bobdrzyzgula/Header-Soldering-Jigs/README.md

# Header Soldering Jigs

*Written by Claude at Bob's direction.*

These are 3D-printable stands for soldering 0.1" pin headers onto microcontroller boards so the headers come out straight. Each board has its own folder with an OpenSCAD model, ready-to-print STLs and a README.

## How the stands work

- **The jig:** a block with a hole for every pin. The holes are drawn at 1.3 mm, go through the full 8 mm thickness of the block, and are chamfered at both ends.
- **Using it:**
  1. Put generic male headers in the holes, **long pins down**, so their plastic bodies sit flat on the top face.
  2. Lay the board on the short pins.
  3. Tack the corners, check that the board is flat, then solder the rest.
- **Why it works:** the depth of the holes keeps the pins parallel. The board rests only on the header bodies, which keeps it square to the pins.

Each board has two versions:

- **`body_bottom`:** the header plastic goes under the board, the normal mounting. The board goes in components up, and the top of the stand is flat.
- **`body_top`:** the header plastic goes on the component side. The board goes in components down, and the top of the stand is pocketed to clear the parts.

## Boards

| Folder | Board | Pins | Geometry source |
|---|---|---|---|
| [`rp2350b-controller/`](rp2350b-controller/) | WeAct Studio RP2350B Core Board, used in the sewing-machine motor controller | 2×15 + 2×15 + 1×4 | `HDK/3D_RP350B.step` from [WeAct's repository](https://github.com/WeActStudio/WeActStudio.RP2350BCoreBoard) |
| [`pico2/`](pico2/) | Raspberry Pi Pico 2 (RP2350A) | 2×20 + 3-pin debug | Raspberry Pi Pico 2 datasheet, Figure 3 |

## KiCad library

[`kicad/`](kicad/) contains footprints and schematic symbols for both boards (the `MCU_Module_Boards` library), for designing carrier boards that host them. Its README has the full pin tables.

## Printing

- Print with the top face up. No supports are needed.
- Holes are drawn at 1.3 mm. FDM printing makes holes smaller than drawn, and the Pico 2 stand printed at 1.0 mm needed its holes opened to 1.3 mm, after which it worked well. If your printer's holes come out tight or loose, adjust `hole_d` in the Customizer (0.05 mm steps).
- Every numeric parameter has a range and step set, so the OpenSCAD Customizer keeps decimal values instead of rounding them to whole numbers.
