bobdrzyzgula/Header-Soldering-Jigs/pico2/pico2_stand_top_views.png

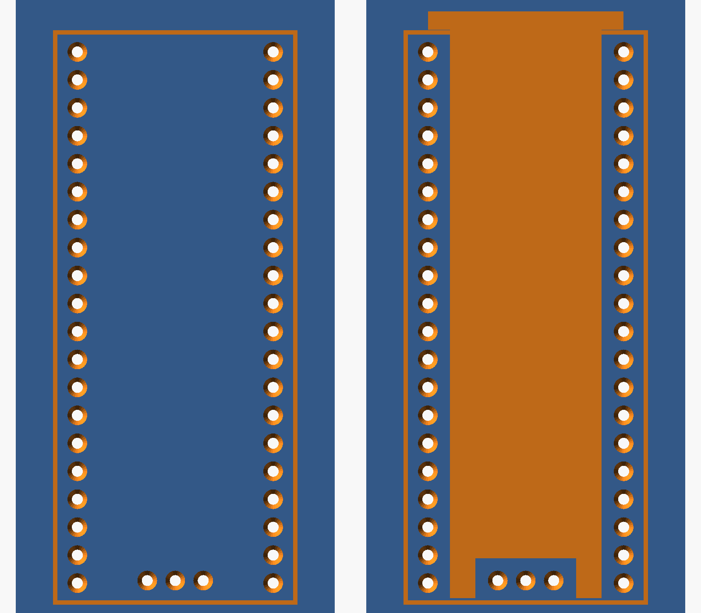
pico2/pico2_stand_top_views.png
