bobdrzyzgula/Header-Soldering-Jigs/rp2350b-controller/rp2350b_stand_body_top_preview.png

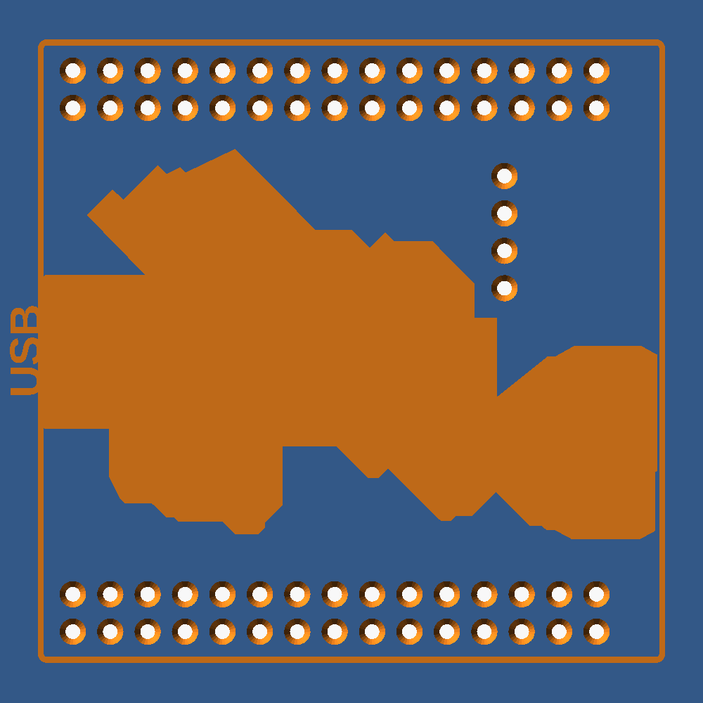
rp2350b-controller/rp2350b_stand_body_top_preview.png
