bobdrzyzgula/Header-Soldering-Jigs/pico2/pico2_stand_body_top.stl

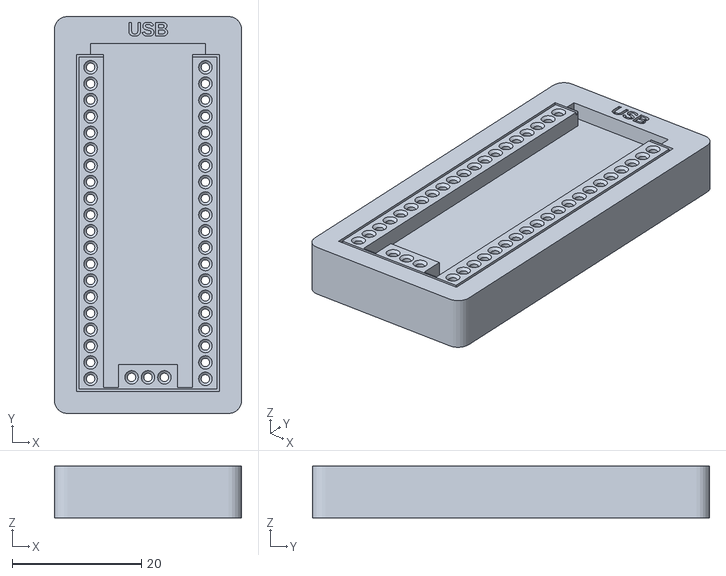
[picture p5: CAD file, 2026-10-26]
pico2/pico2_stand_body_top.stl
29.0 x 61.5 x 8.00
