bobdrzyzgula/Header-Soldering-Jigs/rp2350b-controller/rp2350b_stand_body_bottom.stl

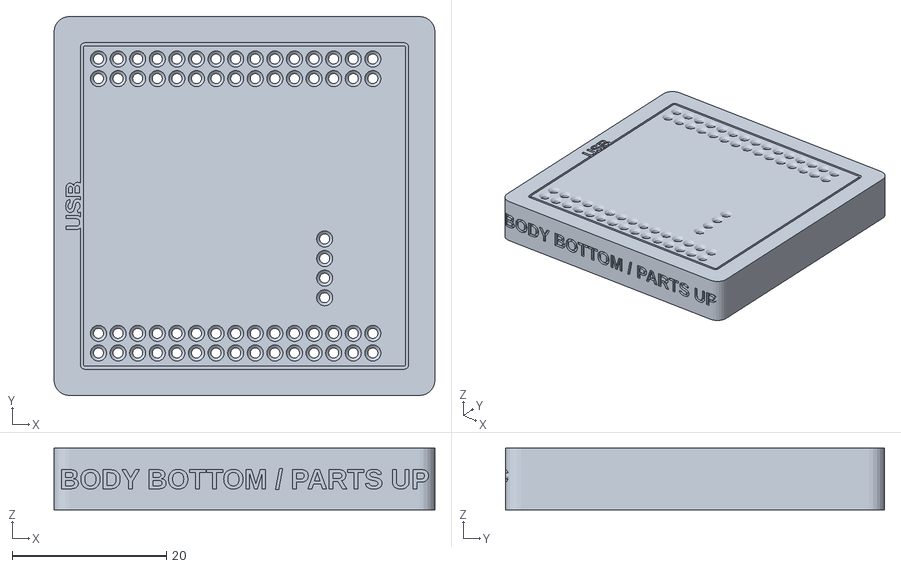
[picture p6: CAD file, 2026-11-07]
rp2350b-controller/rp2350b_stand_body_bottom.stl
49.4 x 49.1 x 8.00
