bobdrzyzgula/Header-Soldering-Jigs/pico2/pico2_stand_body_bottom.stl

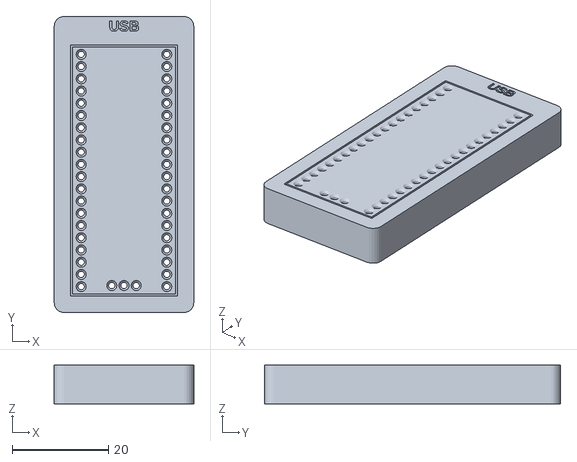
[picture p7: CAD file, 2026-10-26]
pico2/pico2_stand_body_bottom.stl
29.0 x 61.5 x 8.00
