bobdrzyzgula/Header-Soldering-Jigs/rp2350b-controller/rp2350b_data.scad

// ---- Data extracted from 3D_RP350B.step (WeActStudio.RP2350BCoreBoard repo, HDK/, commit 5b165b5; board coordinates, mm; board top face at z=1.6) ----
// Generated by extract_step_to_scad.py
BOARD_MIN = [0.013, -41.135];
BOARD_MAX = [41.389, -0.013];
BOARD_YC  = -20.574;          // centre line the hole pattern is symmetric about (flip axis)
OUTER_PINS = [[1.778,-1.524], [4.318,-1.524], [6.858,-1.524], [9.398,-1.524], [11.938,-1.524], [14.478,-1.524], [17.018,-1.524], [19.558,-1.524], [22.098,-1.524], [24.638,-1.524], [27.178,-1.524], [29.718,-1.524], [32.258,-1.524], [34.798,-1.524], [37.338,-1.524], [1.778,-4.064], [4.318,-4.064], [6.858,-4.064], [9.398,-4.064], [11.938,-4.064], [14.478,-4.064], [17.018,-4.064], [19.558,-4.064], [22.098,-4.064], [24.638,-4.064], [27.178,-4.064], [29.718,-4.064], [32.258,-4.064], [34.798,-4.064], [37.338,-4.064], [1.778,-37.084], [4.318,-37.084], [6.858,-37.084], [9.398,-37.084], [11.938,-37.084], [14.478,-37.084], [17.018,-37.084], [19.558,-37.084], [22.098,-37.084], [24.638,-37.084], [27.178,-37.084], [29.718,-37.084], [32.258,-37.084], [34.798,-37.084], [37.338,-37.084], [1.778,-39.624], [4.318,-39.624], [6.858,-39.624], [9.398,-39.624], [11.938,-39.624], [14.478,-39.624], [17.018,-39.624], [19.558,-39.624], [22.098,-39.624], [24.638,-39.624], [27.178,-39.624], [29.718,-39.624], [32.258,-39.624], [34.798,-39.624], [37.338,-39.624]];
MID_PINS = [[31.090,-24.845], [31.090,-27.385], [31.090,-29.925], [31.090,-32.465]];
MOUNT_HOLES = [[1.143,-40.005], [1.143,-1.143], [40.259,-40.005], [40.259,-1.143]];
// Top-side components: [name, height above board top, 2D convex outline]
COMPONENTS = [
  ["SxsA-C2-0402_SMT_L", 0.50, [[33.010,-19.160], [33.020,-19.170], [33.490,-19.170], [33.510,-19.150], [33.510,-18.190], [33.500,-18.170], [33.010,-18.170]]],
  ["SxsA-C2-0402_SMT_L", 0.50, [[33.170,-14.700], [33.660,-14.700], [33.670,-14.680], [33.670,-13.720], [33.650,-13.700], [33.180,-13.700], [33.170,-13.710]]],
  ["SxsA-C2-0402_SMT_L", 0.50, [[13.090,-9.390], [14.090,-9.390], [14.090,-8.910], [14.070,-8.890], [13.100,-8.890], [13.090,-8.900]]],
  ["SxsA-C2-0402_SMT_L", 0.50, [[26.780,-24.980], [27.470,-25.670], [27.490,-25.670], [27.820,-25.340], [27.830,-25.330], [27.830,-25.320], [27.590,-25.070], [27.510,-24.990], [27.290,-24.770], [27.130,-24.620], [27.110,-24.630], [26.780,-24.960]]],
  ["SxsA-C2-0402_SMT_L", 0.50, [[25.770,-14.950], [26.040,-15.220], [26.450,-15.630], [26.480,-15.630], [26.810,-15.300], [26.810,-15.280], [26.120,-14.590], [26.100,-14.590], [25.770,-14.920]]],
  ["SxsA-C2-0402_SMT_L", 0.50, [[17.260,-15.710], [17.560,-16.010], [17.580,-16.030], [17.950,-16.400], [17.960,-16.400], [18.300,-16.070], [18.300,-16.040], [17.620,-15.360], [17.610,-15.350], [17.600,-15.350], [17.260,-15.680]]],
  ["SxsA-C2-0402_SMT_L", 0.50, [[21.450,-13.400], [21.780,-13.730], [21.810,-13.730], [22.490,-13.050], [22.490,-13.020], [22.160,-12.690], [22.130,-12.690], [21.450,-13.370]]],
  ["SxsA-C2-0402_SMT_L", 0.50, [[28.840,-23.610], [28.850,-23.620], [29.830,-23.620], [29.840,-23.610], [29.840,-23.130], [29.830,-23.120], [28.840,-23.120]]],
  ["SxsA-C2-0402_SMT_L", 0.50, [[17.130,-24.830], [17.470,-25.160], [17.490,-25.160], [17.730,-24.920], [18.170,-24.480], [18.170,-24.450], [17.840,-24.120], [17.820,-24.120], [17.130,-24.800]]],
  ["SxsA-C2-0402_SMT_L", 0.50, [[13.090,-21.210], [13.100,-21.220], [13.570,-21.220], [13.580,-21.210], [13.590,-21.200], [13.590,-20.240], [13.580,-20.220], [13.090,-20.220]]],
  ["SxsA-C2-0402_SMT_L", 0.50, [[14.340,-18.480], [14.670,-18.810], [14.690,-18.810], [15.380,-18.130], [15.380,-18.100], [15.050,-17.770], [15.020,-17.770], [14.340,-18.450]]],
  ["SxsA-C2-0402_SMT_L", 0.50, [[29.070,-17.970], [29.400,-18.300], [29.430,-18.300], [30.110,-17.620], [30.110,-17.590], [29.780,-17.260], [29.750,-17.260], [29.520,-17.490], [29.380,-17.630], [29.070,-17.940]]],
  ["SxsA-C2-0402_SMT_L", 0.50, [[28.180,-15.680], [28.520,-16.020], [28.530,-16.020], [29.070,-15.480], [29.220,-15.330], [29.220,-15.300], [28.890,-14.970], [28.870,-14.970], [28.860,-14.980], [28.720,-15.120], [28.330,-15.510], [28.180,-15.660]]],
  ["SxsA-C2-0402_SMT_L", 0.50, [[25.400,-27.280], [25.420,-27.300], [25.890,-27.300], [25.900,-27.290], [25.900,-26.300], [25.410,-26.300], [25.400,-26.310]]],
  ["SxsA-C2-0402_SMT_L", 0.50, [[19.940,-28.050], [19.950,-28.060], [20.430,-28.060], [20.440,-28.050], [20.440,-27.060], [19.950,-27.060], [19.940,-27.070]]],
  ["SxsA-C2-0402_SMT_L", 0.50, [[14.230,-21.330], [14.250,-21.340], [15.220,-21.340], [15.230,-21.330], [15.230,-20.840], [14.240,-20.840], [14.230,-20.850]]],
  ["SxsA-C2-0402_SMT_L", 0.50, [[5.850,-28.350], [6.170,-28.670], [6.390,-28.890], [6.540,-29.040], [6.560,-29.040], [6.570,-29.030], [6.890,-28.710], [6.900,-28.700], [6.900,-28.690], [6.360,-28.140], [6.210,-28.000], [6.180,-28.000], [5.850,-28.330]]],
  ["SxsA-C2-0402_SMT_L", 0.50, [[17.890,-15.200], [18.150,-15.460], [18.580,-15.890], [18.600,-15.890], [18.940,-15.550], [18.940,-15.540], [18.400,-14.990], [18.250,-14.850], [18.220,-14.850], [17.890,-15.180]]],
  ["SxsA-C2-0402_SMT_L", 0.50, [[13.450,-24.600], [13.790,-24.940], [14.130,-25.280], [14.140,-25.290], [14.150,-25.290], [14.490,-24.960], [14.490,-24.930], [13.800,-24.240], [13.790,-24.240], [13.450,-24.570]]],
  ["SxsA-C2-0402_SMT_L", 0.50, [[27.420,-14.060], [27.580,-14.220], [28.110,-14.750], [28.120,-14.750], [28.460,-14.410], [28.460,-14.390], [28.190,-14.120], [27.920,-13.850], [27.770,-13.700], [27.750,-13.700], [27.420,-14.030]]],
  ["SxsA-C2-0402_SMT_L", 0.50, [[26.400,-10.470], [26.740,-10.810], [26.760,-10.810], [27.300,-10.270], [27.450,-10.110], [27.440,-10.100], [27.110,-9.770], [27.090,-9.770], [26.940,-9.910], [26.830,-10.020], [26.400,-10.450]]],
  ["SxsA-C2-0402_SMT_L", 0.50, [[33.070,-10.470], [33.080,-10.480], [33.570,-10.480], [33.570,-9.490], [33.550,-9.480], [33.090,-9.480], [33.080,-9.490], [33.070,-9.500]]],
  ["SxsA-C2-0402_SMT_L", 0.50, [[8.380,-11.050], [8.870,-11.050], [8.880,-11.040], [8.880,-10.070], [8.860,-10.050], [8.390,-10.050], [8.380,-10.060]]],
  ["COMPOUND", 1.20, [[10.770,-12.300], [11.470,-12.590], [12.950,-12.590], [13.660,-12.300], [13.660,-10.100], [13.650,-10.090], [12.950,-9.810], [11.470,-9.810], [10.770,-10.090]]],
  ["SxsA-C1-C0603", 0.80, [[14.460,-11.980], [14.470,-11.990], [15.250,-11.990], [15.260,-11.980], [15.260,-10.400], [15.250,-10.390], [14.460,-10.390]]],
  ["SxsA-C1-C0603", 0.80, [[9.230,-11.360], [10.020,-11.360], [10.030,-11.350], [10.030,-9.780], [10.010,-9.760], [9.240,-9.760], [9.230,-9.770]]],
  ["COMPOUND", 0.36, [[10.800,-13.710], [11.800,-13.710], [11.800,-13.210], [10.800,-13.210]]],
  ["COMPOUND", 0.36, [[8.890,-22.600], [9.890,-22.600], [9.890,-22.100], [8.890,-22.100]]],
  ["COMPOUND", 0.36, [[10.680,-18.920], [11.680,-18.920], [11.680,-18.420], [10.680,-18.420]]],
  ["COMPOUND", 0.36, [[14.960,-19.100], [15.320,-19.450], [15.540,-19.240], [15.550,-19.230], [15.840,-18.940], [16.020,-18.750], [15.670,-18.390], [14.980,-19.080]]],
  ["COMPOUND", 0.36, [[14.230,-20.440], [15.230,-20.440], [15.230,-19.940], [14.230,-19.940]]],
  ["COMPOUND", 0.36, [[15.470,-26.470], [15.830,-26.820], [15.970,-26.680], [16.360,-26.290], [16.530,-26.110], [16.180,-25.760], [15.950,-25.980], [15.940,-25.990], [15.690,-26.240], [15.610,-26.320]]],
  ["COMPOUND", 0.36, [[14.840,-25.830], [15.190,-26.180], [15.210,-26.170], [15.900,-25.480], [15.540,-25.120], [15.280,-25.380], [14.850,-25.810]]],
  ["COMPOUND", 0.36, [[6.840,-31.450], [6.850,-31.460], [7.010,-31.620], [7.530,-32.140], [7.540,-32.150], [7.900,-31.800], [7.680,-31.580], [7.410,-31.310], [7.190,-31.090]]],
  ["COMPOUND", 0.36, [[8.230,-31.450], [8.370,-31.590], [8.920,-32.140], [8.940,-32.150], [9.290,-31.800], [9.280,-31.780], [9.080,-31.580], [8.810,-31.310], [8.590,-31.090]]],
  ["COMPOUND", 0.36, [[6.840,-30.050], [6.850,-30.070], [7.060,-30.280], [7.540,-30.760], [7.900,-30.400], [7.210,-29.710], [7.190,-29.700]]],
  ["COMPOUND", 0.36, [[5.180,-29.030], [5.510,-29.370], [5.670,-29.530], [5.890,-29.740], [6.250,-29.390], [5.720,-28.860], [5.540,-28.680]]],
  ["COMPOUND", 0.36, [[3.790,-29.800], [4.000,-30.010], [4.270,-30.280], [4.490,-30.500], [4.850,-30.150], [4.280,-29.580], [4.160,-29.460], [4.140,-29.440]]],
  ["COMPOUND", 0.36, [[26.140,-12.780], [26.490,-13.130], [26.830,-13.470], [26.850,-13.480], [27.200,-13.130], [27.180,-13.110], [26.670,-12.600], [26.510,-12.440], [26.490,-12.420]]],
  ["COMPOUND", 0.36, [[33.280,-12.700], [34.280,-12.700], [34.280,-12.200], [33.280,-12.200]]],
  ["COMPOUND", 0.36, [[32.650,-15.850], [33.650,-15.850], [33.650,-15.350], [32.650,-15.350]]],
  ["COMPOUND", 0.36, [[33.280,-11.920], [34.280,-11.920], [34.280,-11.420], [33.280,-11.420]]],
  ["COMPOUND", 0.36, [[31.120,-16.770], [31.620,-16.770], [31.620,-15.770], [31.120,-15.770]]],
  ["COMPOUND", 0.36, [[12.580,-14.980], [13.580,-14.980], [13.580,-14.480], [12.580,-14.480]]],
  ["COMPOUND", 0.60, [[12.170,-17.050], [12.970,-17.050], [12.970,-15.450], [12.170,-15.450]]],
  ["COMPOUND", 0.71, [[34.100,-14.740], [34.350,-14.940], [34.650,-14.940], [34.890,-14.740], [34.900,-14.730], [34.900,-13.550], [34.890,-13.540], [34.640,-13.340], [34.350,-13.340], [34.110,-13.540], [34.100,-13.550]]],
  ["COMPOUND", 0.71, [[8.990,-18.000], [9.000,-18.010], [9.240,-18.210], [9.540,-18.210], [9.780,-18.010], [9.790,-18.000], [9.790,-16.820], [9.780,-16.810], [9.540,-16.610], [9.240,-16.610], [9.000,-16.810], [8.990,-16.820]]],
  ["COMPOUND", 0.71, [[8.850,-21.610], [9.050,-21.850], [9.060,-21.860], [10.250,-21.860], [10.450,-21.610], [10.450,-21.310], [10.250,-21.070], [10.240,-21.060], [9.060,-21.060], [9.050,-21.070], [8.850,-21.320]]],
  ["COMPOUND", 0.71, [[8.730,-19.710], [8.930,-19.950], [8.940,-19.960], [10.110,-19.960], [10.130,-19.940], [10.330,-19.700], [10.330,-19.420], [10.120,-19.160], [8.930,-19.160], [8.730,-19.410]]],
  ["COMPOUND", 0.71, [[33.940,-10.580], [34.190,-10.780], [34.490,-10.780], [34.730,-10.580], [34.740,-10.570], [34.740,-9.400], [34.720,-9.380], [34.480,-9.180], [34.200,-9.180], [33.940,-9.390]]],
  ["COMPOUND", 0.71, [[34.030,-19.260], [34.040,-19.270], [34.290,-19.470], [34.580,-19.470], [34.820,-19.270], [34.830,-19.260], [34.830,-18.070], [34.580,-17.870], [34.280,-17.870], [34.040,-18.070], [34.030,-18.080]]],
  ["SxsA-L1-RP2350_80QFN_minimal:L_pol_2016", 1.01, [[13.750,-23.640], [13.760,-23.670], [14.620,-24.530], [15.050,-24.960], [15.090,-24.980], [15.120,-24.990], [15.140,-24.990], [15.190,-24.970], [15.210,-24.960], [16.200,-23.970], [16.210,-23.950], [16.220,-23.930], [16.230,-23.900], [16.230,-23.880], [16.220,-23.850], [16.210,-23.830], [16.200,-23.810], [14.900,-22.520], [14.880,-22.510], [14.810,-22.510], [14.790,-22.520], [14.770,-22.540], [13.760,-23.550], [13.750,-23.570]]],
  ["COMPOUND", 0.60, [[32.100,-17.290], [33.700,-17.290], [33.700,-16.490], [32.100,-16.490]]],
  ["COMPOUND", 1.75, [[6.990,-27.740], [7.630,-29.080], [11.300,-32.760], [12.640,-33.400], [12.930,-33.120], [15.340,-30.710], [15.620,-30.420], [14.980,-29.080], [11.300,-25.410], [9.960,-24.770], [8.780,-25.950]]],
  ["COMPOUND", 1.05, [[4.970,-12.640], [5.570,-13.860], [5.590,-13.890], [5.620,-13.900], [6.820,-13.900], [6.850,-13.890], [7.470,-13.600], [7.480,-13.590], [7.480,-11.310], [7.470,-11.300], [6.840,-11.000], [5.600,-11.000], [5.580,-11.020], [5.570,-11.040], [4.970,-12.250]]],
  ["SxsA-U5-RP2350_80QFN_minimal:RP2350-QFN-", 0.87, [[15.920,-20.510], [16.690,-21.300], [16.830,-21.440], [22.060,-26.670], [22.200,-26.810], [22.990,-27.580], [24.200,-26.390], [27.170,-23.420], [29.290,-21.300], [30.060,-20.510], [29.150,-19.580], [25.190,-15.620], [24.200,-14.630], [22.990,-13.440], [22.200,-14.210], [22.060,-14.350], [20.080,-16.330], [16.830,-19.580]]],
  ["SxsA-SW1-SW-SMD_4P-L4.2-W3.3-P2.15-LS5.1", 2.50, [[35.500,-15.570], [36.000,-15.850], [40.200,-15.850], [40.700,-15.570], [40.700,-12.870], [40.200,-12.600], [36.000,-12.600], [35.500,-12.870]]],
  ["SxsA-SW1-SW-SMD_4P-L4.2-W3.3-P2.15-LS5.1", 2.50, [[35.370,-11.510], [35.870,-11.790], [40.070,-11.790], [40.570,-11.510], [40.570,-8.810], [40.070,-8.540], [35.870,-8.540], [35.370,-8.810]]],
  ["SxsA-SW1-SW-SMD_4P-L4.2-W3.3-P2.15-LS5.1", 2.50, [[35.500,-19.890], [36.000,-20.170], [40.200,-20.170], [40.700,-19.890], [40.700,-17.190], [40.200,-16.920], [36.000,-16.920], [35.500,-17.190]]],
  ["COMPOUND", 0.66, [[26.810,-11.890], [28.810,-13.890], [29.070,-13.890], [30.570,-12.390], [30.570,-12.110], [28.660,-10.200], [28.580,-10.120], [28.310,-10.120], [26.810,-11.620]]],
  ["COMPOUND", 3.20, [[0.150,-24.930], [0.200,-24.980], [7.450,-24.980], [7.900,-23.970], [7.900,-17.060], [7.450,-16.040], [0.200,-16.040], [0.150,-16.090]]]
];
