bobdrzyzgula/Header-Soldering-Jigs/(commit log)

2026-10-26 Add header soldering stands for the RP2350B controller board and Pico 2
    Each board folder has an OpenSCAD model, STLs for header bodies under the
    board and on the component side, and a README with usage instructions.
    - rp2350b-controller: geometry extracted from the board's EasyEDA STEP
    file, plus the extraction script used to generate the data file
    - pico2: geometry from Figure 3 of the Raspberry Pi Pico 2 datasheet
    Claude-Session: https://claude.ai/code/session_01DGDszAin769UDAFocid54d
    [pico2_header_stand.scad, pico2_stand_body_bottom.stl, pico2_stand_body_top.stl, rp2350b_data.scad, rp2350b_header_stand.scad, rp2350b_stand_body_bottom.stl, rp2350b_stand_body_top.stl]
2026-10-26 Credit WeAct Studio's repository as the RP2350B STEP source
    The RP2350B controller board is WeAct Studio's RP2350B Core Board. Its
    STEP model is HDK/3D_RP350B.step in WeActStudio/WeActStudio.RP2350BCoreBoard
    (commit 5b165b5), identical to the file the data was extracted from.
    Update the READMEs, file headers and regeneration instructions to point
    there. Geometry and STLs are unchanged.
    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
    [rp2350b_data.scad, rp2350b_header_stand.scad]
2026-10-26 Add KiCad footprints and symbols for the WeAct RP2350B and Pico 2
    New kicad/ folder with the MCU_Module_Boards library: a carrier-board
    footprint and a schematic symbol for each module, the generator script,
    and a README with pin tables and setup instructions.
    - WeAct RP2350B Core Board: hole positions from HDK/3D_RP350B.step;
    signals from WeAct's pinout chart, checked against RP2350B_SCH.pdf.
    Pad numbers follow the schematic's H1/H2/H4 headers.
    - Raspberry Pi Pico 2: positions and pin numbering from the Pico 2
    datasheet (Figures 2-4).
    Files are KiCad 7 format and were parsed and plotted with kicad-cli 7.0.
    Claude-Session: http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
2026-10-26 Add instructions for adding new boards
    CLAUDE.md records that each new board gets a soldering stand and a KiCad
    footprint and symbol, the defaults for each, the sources to prefer, and
    when to stop and ask for missing pin or hole information.
    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
2026-10-26 Default stand holes to 1.3 mm; add Customizer ranges
    A printed Pico 2 stand needed its 1.0 mm holes opened to 1.3 mm, after
    which it worked well, so 1.3 mm is now the default hole_d in both models.
    Every numeric parameter now has a [min:step:max] range, with its
    description on the line above, so the OpenSCAD Customizer no longer drops
    decimals. STLs rebuilt; READMEs and CLAUDE.md updated to match.
    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
    [pico2_header_stand.scad, pico2_stand_body_bottom.stl, pico2_stand_body_top.stl, rp2350b_header_stand.scad, rp2350b_stand_body_bottom.stl, rp2350b_stand_body_top.stl]
2026-11-07 Updated rp2350b STls
    [rp2350b_stand_body_bottom.stl, rp2350b_stand_body_top.stl]
